htminuslab/Efinix_T20_Dev_Board/Examples/README.md

# 7 FPGA Examples

## 7.1 Hello World example

The "Hello World" design of an FPGA is normally a blinking LED, you can find such an example in the **examples\blink_led** directory. To upload this example issue the following command *(adjust -com xx for your com port)*:

```
EfinixLoader.exe -com 7 Example\blink_led\blink.hex
```
Note. The 3 LED's should now be blinking. 

<p align="center">
Blinking LED's
</p>

## 7.2 PLL Example

This is the same blinking LED example except a PLL is instantiated in the source, for this to work you need to enable the **Unified Netlist Flow** in the Efinity software (under edit project).

```
EfinixLoader.exe -com 7 Example\pll_test\pll_test.hex
```
Note. The 3 LED's should now again be blinking but this time driven by a 48MHz clock. 

## 7.3 UART bridge example

The on-board microcontroller provides an FPGA-UART to PC-UART (uart2uart) bridge. This makes it easy to connect your IP (with a UART) to the PC without requiring an external UART USB cable. 

<p align="center">
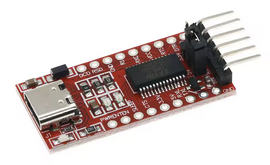
[picture p10: Examples/uart_ttl.png]
UART to TTL converter

</p>

You can find an example in the **examples\uart_echo** directory. This example echos back any characters it receives from the PC and adds one. Thus if you send a character '1' the program will echo back '2'. You will need terminal program like [putty](https://www.chiark.greenend.org.uk/~sgtatham/putty/latest.html) /teraterm to communicate with the board. The single tiny push button (GPIOB_TXP04,32) is connected to reset.

```
EfinixLoader.exe -com 7 Example\uart_echo\uart_echo.hex
```

The uart2uart bridge operates with a default bitrate of 115200bps, in this example the FPGA UART uses 9600,N,8,1 so we need to adjust the baudrate of the link. We can do this with the -fpgabaudrate argument:

```
h:\GitHub\Efinix_T20_Dev_Board\EfinixLoader>EfinixLoader.exe -com 7 -fpgabaudrate 9600
```
 
<p align="center">
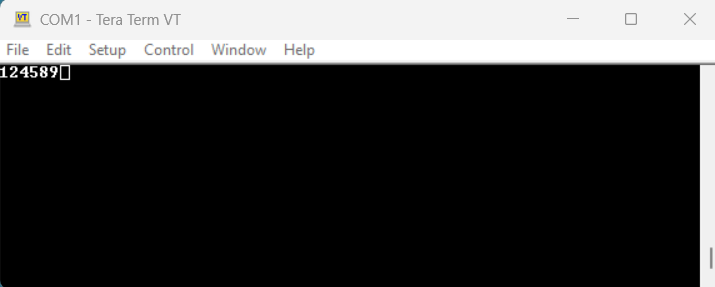
[picture p11: Examples/teraterm.png]
Teraterm connection

</p>
<p align="center">
Figure1: echo_uart example, sending '1' '4' '8'
</p>

## 7.4 Pin Toggle example

The on-board microcontroller has 17 pin connections with the Efinix FPGA. Some of these pins can be configured as input, output or special function such as UART TX/RX. The **examples\pin_level** directory contains a simple example that writes pin value (CMD input) as a string to the uart2uart bridge. The pin value and the reset are both controlled via the EfinixLoader program.

```
EfinixLoader.exe -com 7 Example\pin_level_pll\pin_level_pll.hex
```
Connect a terminal program to the second comport, use 115200,N,8,1 (any baudrate will work as we are talking to a USB UART not the FPGA UART). 

The STM32C071 pin PA15 is connected to the RESETN signal, and PC15 to the CMD input. Both pins default to input mode after power-up so to configure them as output we need to issue the following commands:

```
EfinixLoader.exe -com 7 -setdira 15 0
EfinixLoader.exe -com 7 -setdirc 15 0
```
These commands will change PA15/PC15 to 0=Output. You can now use the -setpin argument to change the pin value, for example to change the CMD pin (PC15) to 0 use:

```
EfinixLoader -com 7 -setpinc 15 0
```

To change it back to 1 use:

```
EfinixLoader -com 7 -setpinc 15 1
```

See batch file toggle_cmd.bat which toggles this pin a few times.  

Once you are done with the test it is recommended to change the port back to input(1):

```
EfinixLoader.exe -com 7 -setdira 15 1
EfinixLoader.exe -com 7 -setdirc 15 1
```

<p align="center">
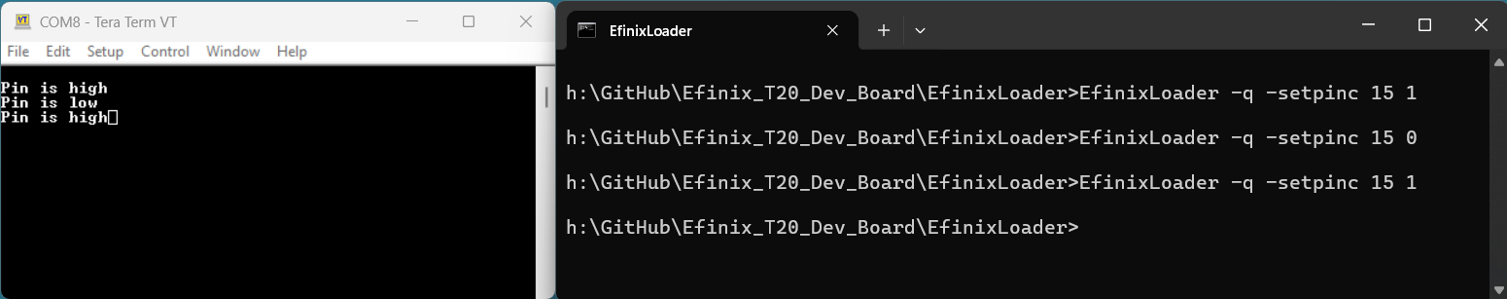
[picture p12: Examples/pin_level_pll.png]
pin_level_pll example

</p>
<p align="center">
Figure2:pin_level_pll example 
</p>

<span style="color:red">Please note there are no current limiting resistors between the STM32C071 and the T20Q100F3, so the user is responsible to not drive both the STM32C071 pin and the T20Q100F3 pin at the same time!</span>

<span style="color:red">In addition, this board does have an extra ESD protection on the I/O pins, so the usual common sense electronic component handling is required.</span> 

## 7.5 NEORV32 RISC-V Example

Every development boards needs a RISC-V core (ideally running Doom...:-), I picked the [NEORV32](https://github.com/stnolting/neorv32) which is a great core fully documented and available in VHDL/Verilog. I selected the "neorv32_ProcessorTop_MinimalBoot" configuration and added a PLL to increase the clock from 12 to 62.67MHz. I also recompiled the NEORV32 bootloader (neorv32-main/sw/bootloader) and some of the examples to use 115200bps instead of the default 19200. The amount of effort to get this core up and running was minimal which shows the quality of this core.

<p align="center">
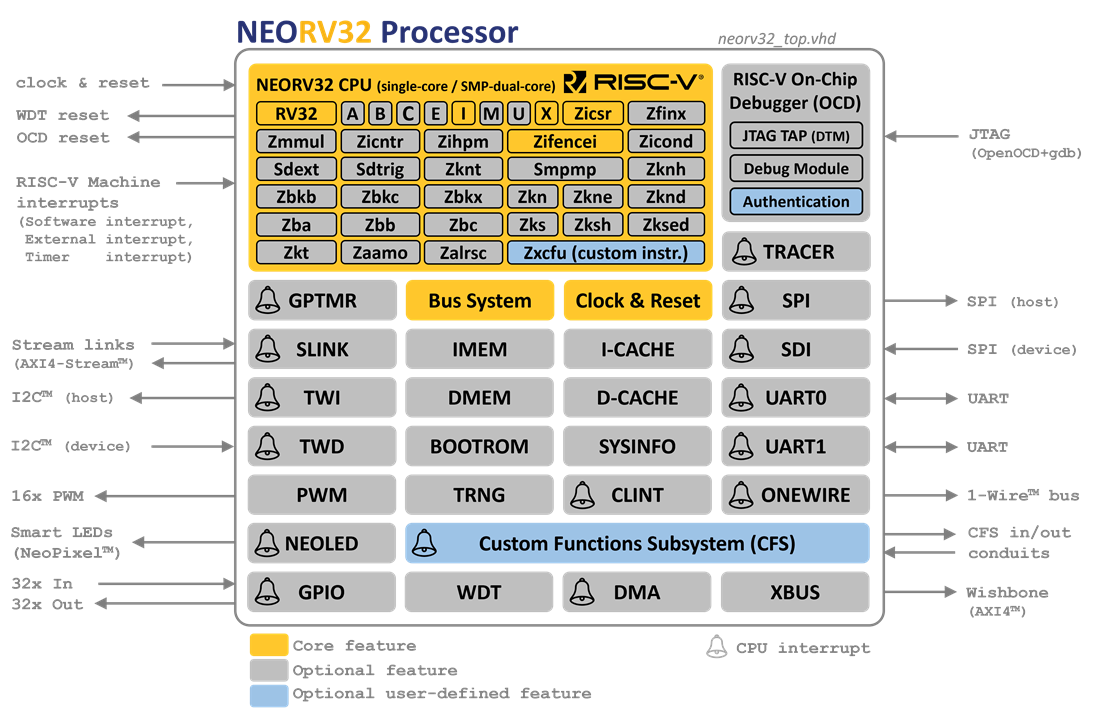
[picture p13: Examples/neorv32_processor.png]
NEORV32 RISC-V IP core

</p>
<p align="center">
Figure3: NEORV32 RISC-V IP core by Stephan Nolting
</p>

To load the design use:

```
EfinixLoader.exe -com 7 Example\neorv32_riscv\risc-v.hex
```

The RV32I core is configured with a single UART connected to the uart2uart bridge (115200,N,9,1). The reset pin is connected to PC15 and the PIO to the LEDs. After loading the design the terminal connected to the uart2uart bridge should show the bootloader menu, if not toggle the reset (see reset.bat file).

Once you have the bootloader you can upload a file and execute it. For this make sure you select binary option on your terminal (for example Tera Term) and disable the local echo. There are 2 example I pre-compiled, helloworld.bin and demo_blink_led.bin. Figure8 shows the helloworld.bin example output, after this excute reset.bat to get back to the bootloader menu.

<p align="center">
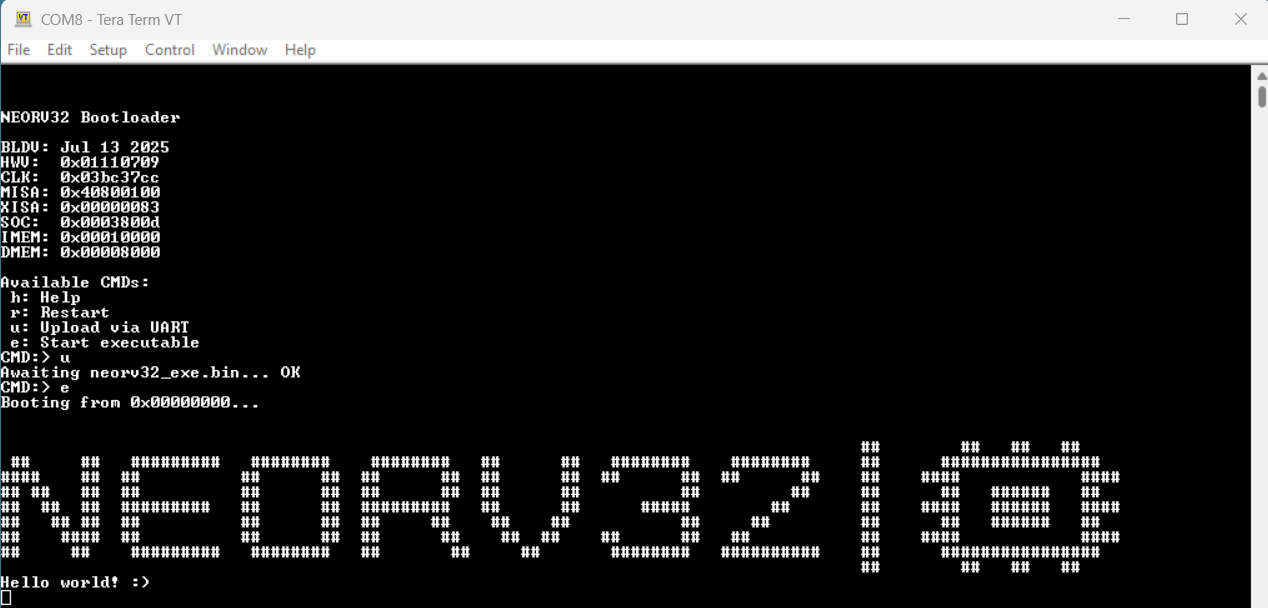
[picture p14: Examples/teraterm_riscv.png]
Teraterm running NEORV32 bootloader

</p>
<p align="center">
Figure4: Teraterm running NEORV32 bootloader
</p>

Here are the push-button synthesis results

```
---------- Resource Summary (begin) ----------
Inputs: 5 / 163 (3.07%)
Outputs: 6 / 347 (1.73%)
Clocks: 2 / 16 (12.50%)
Logic Elements: 5736 / 19728 (29.08%)
	LE: LUTs/Adders: 4378 / 19728 (22.19%)
	LE: Registers: 2379 / 13920 (17.09%)
Memory Blocks: 199 / 204 (97.55%)
Multipliers: 0 / 36 (0.00%)
---------- Resource Summary (end) ----------
---------- 1. Clock Frequency Summary (begin) ----------
User target constrained clocks
      Clock Name        Period (ns)  Frequency (MHz)   Waveform             Targets
EFX_PLL_V2_inst~CLKOUT0    15.957        62.668      {0.000 7.978} {EFX_PLL_V2_inst~CLKOUT0}

Maximum possible analyzed clocks frequency
      Clock Name        Period (ns)  Frequency (MHz)     Edge
EFX_PLL_V2_inst~CLKOUT0    13.089        76.400         (R-R)

Geomean max period: 13.089
---------- Clock Frequency Summary (end) ---------------
```

## 7.5.1 RISC-V RTL Simulation

I have also created a simple batch file for Questa/Modelsim to perform rtl and gatelevel simulation. Navigate to the sim directory and execute run_questa.bat in a CMD prompt, the output should be something like:

```
# set NumericStdNoWarnings 1
# 1
#  nolog -r /*
#  run 40 ms
# ** Note: [NEORV32] Implementing processor-internal IMEM as blank RAM.
#    Time: 0 ps  Iteration: 0  Instance: /neorv32_efinix_tb/U_DUT/neorv32_inst/memory_system/neorv32_int_imem_enabled/neorv32_int_imem_inst
# ** Warning: [NEORV32] Assuming this is a simulation.
#    Time: 0 ps  Iteration: 0  Region: /neorv32_efinix_tb/U_DUT/neorv32_inst/core_complex_gen(0)/neorv32_cpu_inst/hello_neorv32
# ** Note: [NEORV32] CPU tuning options:
#    Time: 0 ps  Iteration: 0  Region: /neorv32_efinix_tb/U_DUT/neorv32_inst/core_complex_gen(0)/neorv32_cpu_inst/hello_neorv32
# ** Note: [NEORV32] CPU ISA: rv32ix_zicntr_zicsr_zifencei
#    Time: 0 ps  Iteration: 0  Region: /neorv32_efinix_tb/U_DUT/neorv32_inst/core_complex_gen(0)/neorv32_cpu_inst/hello_neorv32
# ** Note: [NEORV32] BOOT_MODE_SELECT = 0: booting via bootloader
#    Time: 0 ps  Iteration: 0  Region: /neorv32_efinix_tb/U_DUT/neorv32_inst/sanity_checks
# ** Note: [NEORV32] Processor Configuration: CPU (single-core) IMEM DMEM BOOTROM CLINT GPIO UART0 SYSINFO
#    Time: 0 ps  Iteration: 0  Region: /neorv32_efinix_tb/U_DUT/neorv32_inst/sanity_checks
# ** Note: [NEORV32] The NEORV32 RISC-V Processor (v01.11.07.09), github.com/stnolting/neorv32
#    Time: 0 ps  Iteration: 0  Region: /neorv32_efinix_tb/U_DUT/neorv32_inst/sanity_checks
# N =  1, M =  94, O = 2, DIV0 =   9, DIV1 =   2, DIV2 =   2
# Using internal feedback
# CLKIN reference clock period = 83.3340 ns (12.00 MHz)
# VCO period = 0.8865 ns (1127.99 MHz)
# PLL period = 1.7731 ns (564.00 MHz)
# CLKOUT0 period = 15.9576 ns (62.67 MHz), shift = 0.0000 ns
# CLKOUT1 period = 3.5461 ns (282.00 MHz), shift = 0.0000 ns
# CLKOUT2 period = 3.5461 ns (282.00 MHz), shift = 0.0000 ns
# Reached Lock @ 1041.67 ns
# UART0:
# UART0: NEORV32 Bootloader
# UART0:
# UART0: BLDV: Jul 12 2025
# UART0: HWV:  0x01110709
# UART0: CLK:  0x03bc37cc
# UART0: MISA: 0x40800100
# UART0: XISA: 0x80000083
# UART0: SOC:  0x0003800d
# UART0: IMEM: 0x00008000
# UART0: DMEM: 0x00008000
# UART0:
# UART0: Available CMDs:
# UART0:  h: Help
# UART0:  r: Restart
# UART0:  u: Upload via UART
# UART0:  e: Start executable
```

## 7.5.2 RISC-V Gate Level Simulation

For gatelevel you first need to compiled the Efinix primitives into a library, you can do this with the following batch file (fix the <?> path):

```
vlib Efinix
vmap Efinix Efinix
vlog -quiet -work Efinix <?>/Efinity/2025.1/sim_models/verilog/*.v
vlog -quiet -work Efinix <?>/Efinity/2025.1/pt/sim_models/verilog/*.v

```
You will now have the gatelevel primitive and the simulation primitives (like EFX_PLL_V2) in the Efinix library. The gatelevel sim (structural only) can now be executed by the run_questa_gate.bat batch file:

```
# Loading std.standard
# Loading std.textio(body)
# Loading ieee.std_logic_1164(body)
# Loading ieee.numeric_std(body)
# Loading work.neorv32_efinix_tb(struct)#1
# Loading work.neorv32_efinix(fast)
# set NumericStdNoWarnings 1
# 1
#  nolog -r /*
#  run 40 ms
# N =  1, M =  94, O = 2, DIV0 =   9, DIV1 =   2, DIV2 =   2
# Using internal feedback
# CLKIN reference clock period = 83.3340 ns (12.00 MHz)
# VCO period = 0.8865 ns (1127.99 MHz)
# PLL period = 1.7731 ns (564.00 MHz)
# CLKOUT0 period = 15.9576 ns (62.67 MHz), shift = 0.0000 ns
# CLKOUT1 period = 3.5461 ns (282.00 MHz), shift = 0.0000 ns
# CLKOUT2 period = 3.5461 ns (282.00 MHz), shift = 0.0000 ns
# Reached Lock @ 1041.67 ns
# UART0:
# UART0: NEORV32 Bootloader
# UART0:
# UART0: BLDV: Jul 12 2025
# UART0: HWV:  0x01110709
# UART0: CLK:  0x03bc37cc
..etc
```

## 7.6 PLL Clock Output example

This example shows how to direct a PLL clock output to an I/O pin using the Unified Netlist mode. The PLL generates 48MHz from a 12MHz input clock signal.

```
EfinixLoader.exe -com 7 Example\pll_clkout\pll_clkout.hex
```

<p align="center">
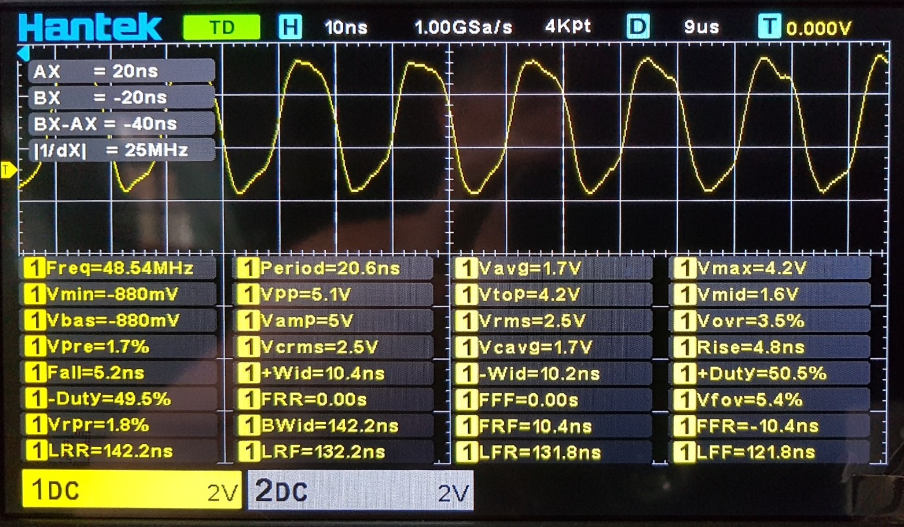
[picture p15: Examples/scope_clkout.jpg]
PLL Clock Out signal

</p>
<p align="center">
Figure5: PLL Clock output signal
</p>

## 7.7 Efinix Sapphire Lite core

Efinix has it own fully configurable RISC-V core based on the [award winning](https://riscv.org/blog/2018/12/risc-v-softcpu-contest-highlights/) [VexRISCV](https://github.com/SpinalHDL/VexRiscv) core. In addition to the core Efinix provide an easy to use Eclipse IDE. For this demo I selected the "lite" configuration with a single UART and the "uartEchodemo" example pre-loaded into memory (64KByte). To reduce the number of files I have stripped most of the IP files and just kept the files required to synthesise the core and to run RTL/Gatelevel sim. Re-generating the full core and restoring all the files is easy to do.

Here are some push-button synthesis results (all default values used in Efinity)

```
--------------- Resource Summary (begin) ---------------
Inputs:             4 / 163         (2.45%)
Outputs:            2 / 347         (0.58%)
Clocks:             1 / 16          (6.25%)
Logic Elements:     3046 / 19728    (15.44%)
   LE: LUTs/Adders: 2407 / 19728    (12.20%)
   LE: Registers:   1549 / 13920    (11.13%)
Memory Blocks:      134 / 204       (65.69%)
Multipliers:        0 / 36          (0.00%)
---------------- Resource Summary (end) ----------------

---------- 1. Clock Frequency Summary (begin) ----------
User target constrained clocks
      Clock Name        Period (ns)  Frequency (MHz)   Waveform             Targets
EFX_PLL_V2_inst~CLKOUT0    10.000        100.000     {0.000 5.000} {EFX_PLL_V2_inst~CLKOUT0}
Maximum possible analyzed clocks frequency
      Clock Name        Period (ns)  Frequency (MHz)     Edge
EFX_PLL_V2_inst~CLKOUT0    8.978        111.383         (R-R)
Geomean max period: 8.978
---------- Clock Frequency Summary (end) ---------------
```

**A RISC-V core with 64Kbyte of memory, 2Mbyte of Flash running at 111MHz(Timing_3) using just 16% of the available luts on a &pound;8 FPGA is quite good going (08/25).**

To load the design, start Teraterm(115200,N,8,1) or any other terminal program and execute:

```
EfinixLoader.exe -com 7 Examples\Efinix_riscv_lite\Efinix_riscv.hex
```

<p align="center">
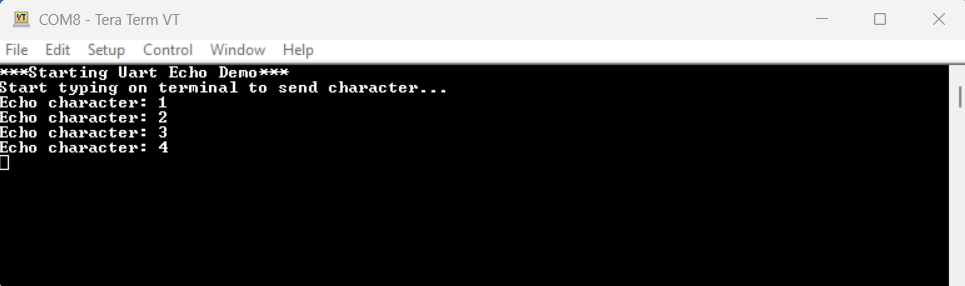
[picture p16: Examples/Efinix_riscv_echo.png]
Sapphire Uart Echo Demo

</p>
<p align="center">
Figure6: Sapphire Uart Echo Demo
</p>

The RESETN signal is connected to the microcontroller PA15 so to reset the core change the pin PA15 to output and then toggle it low and high.

```
EfinixLoader -q -com 7 -setdira 15 0
EfinixLoader -q -com 7 -setpina 15 0
EfinixLoader -q -com 7 -setpina 15 1
```

## 7.7.1 Efinix Sapphire Lite RTL Simulation

Similar to the neorv32 example to run RTL simulation navigate to the sim directory and execute the run_questa.bat file in a CMD prompt. You will first need to compile the Efinix primitives and sim_models into a "Efinix" library as shown under the neorv32 example.

```
# Loading work.t20_top_riscv_tb(rtl)#1
# Loading Efinix.EFX_PLL_V2(fast)
# Loading work.T20_Sapphire(fast)
# set NumericStdNoWarnings 1
# 1
#  nolog -r /*
#  run -all
# N =  1, M = 100, O = 2, DIV0 =   6, DIV1 =   2, DIV2 =   2
# Using internal feedback
# CLKIN reference clock period = 83.3340 ns (12.00 MHz)
# VCO period = 0.8333 ns (1199.99 MHz)
# PLL period = 1.6667 ns (600.00 MHz)
# CLKOUT0 period = 10.0001 ns (100.00 MHz), shift = 0.0000 ns
# CLKOUT1 period = 3.3334 ns (300.00 MHz), shift = 0.0000 ns
# CLKOUT2 period = 3.3334 ns (300.00 MHz), shift = 0.0000 ns
# Reached Lock @ 625.00 ns
# UART0: ***Starting Uart Echo Demo***
# UART0: Start typing on terminal to send character...
# Break key hit
# Simulation stop requested.
#  quit -f
```

## 7.7.2 Efinix Sapphire Lite GLS

For the gatelevel execute run_questa_gate.bat.

## 7.8 Flash/PSRAM Example

An easy way to access the embedded T20Q100F3 FLASH chip and external PSRAM chip is by using the Sapphire RISC-V core as it has all the peripherals you need (SPI/UART/PIO). For this example I picked the **standard** Sapphire core which, unlike the Lite version is optimised for performance. I configured the standard core with 4Kbyte I/D cache and added an extra SPI controller as shown below. 

<p align="center">
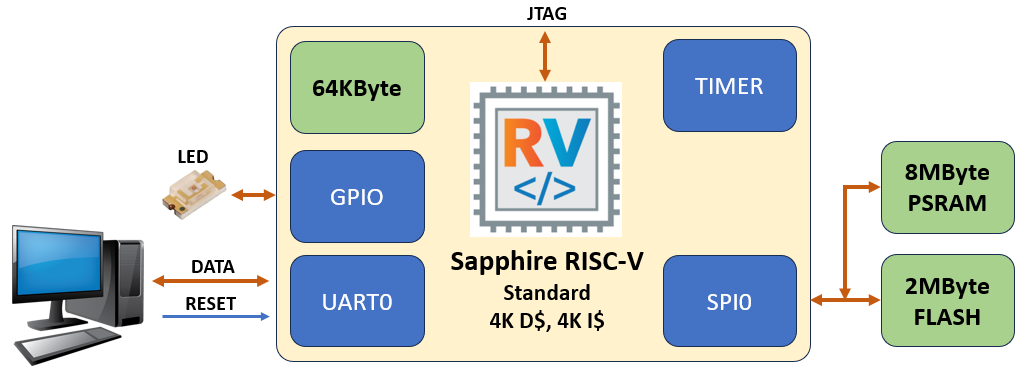
[picture p17: Examples/Efinix_riscv_standard.png]
Sapphire Flash Read test

</p>
<p align="center">
Figure7: Read flash with the Sapphire core
</p>

Next I wrote a quick program to read the first sector of both the FLASH and PSRAM and output the results to the UART, see *Examples\Efinix_riscv_standard\embedded_sw\T20_Sapphire\software\standalone\dumpFlash*. The RESETN signal is again connected to PA15. 

Before loading the Sapphire RISC core load the PSRAM and Flash with a recognisable pattern:

```
EfinixLoader.exe -com 7 -psram Examples\Efinix_riscv_standard\pattern1.hex
EfinixLoader.exe -com 7 -flash Examples\Efinix_riscv_standard\pattern2.hex
```

Next load the Sapphire Standard core which will display the first sector of both the Flash and PSRAM straight after reset:

```
EfinixLoader.exe -com 7 Examples\Efinix_riscv_standard\Efinix_riscv_standard.hex
```

Open a terminal and connect Teraterm(115200,n,8,1) to the UART2UART bridge comport. Once the program is loaded it should display the flash and PSRAM contents:

```
*** Device ID : 00000014

*** Dump First Page of FLASH:

00000000: 56 65 72 73 69 6F 6E 3A 20 32 30 32 35 2E 31 2E
00000010: 31 31 30 2E 31 2E 35 0A 47 65 6E 65 72 61 74 65
00000020: 64 3A 20 53 61 74 20 4A 75 6E 20 32 38 20 30 39
00000030: 3A 31 38 3A 35 31 20 32 30 32 35 0A 0A 50 72 6F
00000040: 6A 65 63 74 3A 20 48 3A 5C 47 69 74 48 75 62 5C
00000050: 45 66 69 6E 69 78 5F 54 32 30 5F 44 65 76 5F 42
00000060: 6F 61 72 64 5C 45 78 61 6D 70 6C 65 73 5C 62 6C
00000070: 69 6E 6B 5F 6C 65 64 0A 46 61 6D 69 6C 79 3A 20
00000080: 54 72 69 6F 6E 0A 44 65 76 69 63 65 3A 20 54 32
00000090: 30 51 31 30 30 46 33 0A 57 69 64 74 68 3A 20 31
000000a0: 0A 4D 6F 64 65 3A 20 70 61 73 73 69 76 65 0A 50
000000b0: 41 44 44 45 44 5F 42 49 54 53 3A 20 30 0A 0A 0A
000000c0: 0A 0A 0A 0A 0A 0A 0A 0A 0A 0A 0A 0A 0A 0A 0A 0A
000000d0: 0A 0A 0A 0A 0A 0A 0A 0A 0A 0A 0A 0A 0A 0A 0A 0A
000000e0: 0A 0A 0A 0A 0A 0A 0A 0A 0A 0A 0A 0A 0A 0A 0A 0A
000000f0: 0A 0A 0A 0A 0A 0A 0A 0A 0A 0A 0A 0A 0A 0A 0A 0A

*** Dump First Page of PSRAM:

00000000: 01 02 03 04 05 06 07 08 09 0A 0B 0C 0D 0E 0F 20
00000010: 21 22 23 24 25 26 27 28 29 2A 2B 2C 2D 2E 2F 30
00000020: 0A 0A 0A 0A 0A 0A 0A 0A 0A 0A 0A 0A 0A 0A 0A 0A
00000030: 0A 0A 0A 0A 0A 0A 0A 0A 0A 0A 0A 0A 0A 0A 0A 0A
00000040: 0A 0A 0A 0A 0A 0A 0A 0A 0A 0A 0A 0A 0A 0A 0A 0A
00000050: 0A 0A 0A 0A 0A 0A 0A 0A 0A 0A 0A 0A 0A 0A 0A 0A
00000060: 0A 0A 0A 0A 0A 0A 0A 0A 0A 0A 0A 0A 0A 0A 0A 0A
00000070: 0A 0A 0A 0A 0A 0A 0A 0A 0A 0A 0A 0A 0A 0A 0A 0A
00000080: 0A 0A 0A 0A 0A 0A 0A 0A 0A 0A 0A 0A 0A 0A 0A 0A
00000090: 0A 0A 0A 0A 0A 0A 0A 0A 0A 0A 0A 0A 0A 0A 0A 0A
000000a0: 0A 0A 0A 0A 0A 0A 0A 0A 0A 0A 0A 0A 0A 0A 0A 0A
000000b0: 0A 0A 0A 0A 0A 0A 0A 0A 0A 0A 0A 0A 0A 0A 0A 0A
000000c0: 0A 0A 0A 0A 0A 0A 0A 0A 0A 0A 0A 0A 0A 0A 0A 0A
000000d0: 0A 0A 0A 0A 0A 0A 0A 0A 0A 0A 0A 0A 0A 0A 0A 0A
000000e0: 0A 0A 0A 0A 0A 0A 0A 0A 0A 0A 0A 0A 0A 0A 0A 0A
000000f0: 0A 0A 0A 0A 0A 0A 0A 0A 0A 0A 0A 0A 0A 0A 0A 0A

Done

```
The Flash output should be the same as pattern1.hex, the PSRAM should display pattern2.hex.

If you get all **"FF"** for the Flash page, issue a reset as the flash might take some time to get out of deep sleep mode. 

```
H:\GitHub\Efinix_T20_Dev_Board\EfinixLoader>..\Examples\Efinix_riscv_lite\toggle_reset.bat
```

## 7.8.1 Efinix Sapphire Standard RTL Simulation

Similar to the previous RISC-v examples to run RTL simulation navigate to the sim directory and execute the run_questa.bat file in a CMD prompt. The flash model (W25Q32JVxxIM.v) is initialised with the content of MEM_IM.txt the PSRAM is not connected and will display all ".".  

```
# Loading work.T20_Sapphire(fast)
# Loading Efinix.EFX_PLL_V2(fast)
# Loading work.W25Q32JVxxIM(fast)
# set NumericStdNoWarnings 1
# 1
#  nolog -r /*
#  run -all
# N =  1, M = 100, O = 2, DIV0 =   6, DIV1 =   2, DIV2 =   2
# Using internal feedback
# CLKIN reference clock period = 83.3340 ns (12.00 MHz)
# VCO period = 0.8333 ns (1199.99 MHz)
# PLL period = 1.6667 ns (600.00 MHz)
# CLKOUT0 period = 10.0001 ns (100.00 MHz), shift = 0.0000 ns
# CLKOUT1 period = 3.3334 ns (300.00 MHz), shift = 0.0000 ns
# CLKOUT2 period = 3.3334 ns (300.00 MHz), shift = 0.0000 ns
# Reached Lock @ 625.00 ns
#
# Command = ab
#
# Command = 03
# UART0:
# UART0: *** Device ID : 00000015
# UART0:
# UART0: *** Dump First Page of Flash:
# UART0:
# UART0: 00000000: 56 65 72 73 69 6F 6E 3A 20 32 30 32 35 2E 31 2E
# UART0: 00000010: 31 31 30 2E 31 2E 35 0A 47 65 6E 65 72 61 74 65
# UART0: 00000020: 64 3A 20 57 65 64 20 4A 75 6C 20 33 30 20 30 38
# UART0: 00000030: 3A 33 37 3A 30 32 20 32 30 32 35 0A 0A 50 72 6F
# UART0: 00000040: 6A 65 63 74 3A 20 48 3A 5C 47 69 74 48 75 62 5C
...
```

## 7.8.2 Efinix Sapphire Standard GLS

[TBC]

## 7.9 Create your own design

To create your own design you need the [Efinix Efinity Place&Route](https://www.efinixinc.com/products-efinity.html) software. You need to sign-up to get a free license. I would also suggest you check out the [forum](https://forum.efinix.net/latest) which has some good advice on various issues.

## License

- All example code is licensed under the [MIT License](../MIT_License.txt).

## Notice
All other trademarks are the property of their respective owners.
