htminuslab/Efinix_T20_Dev_Board/Examples/teraterm_readpsram.png

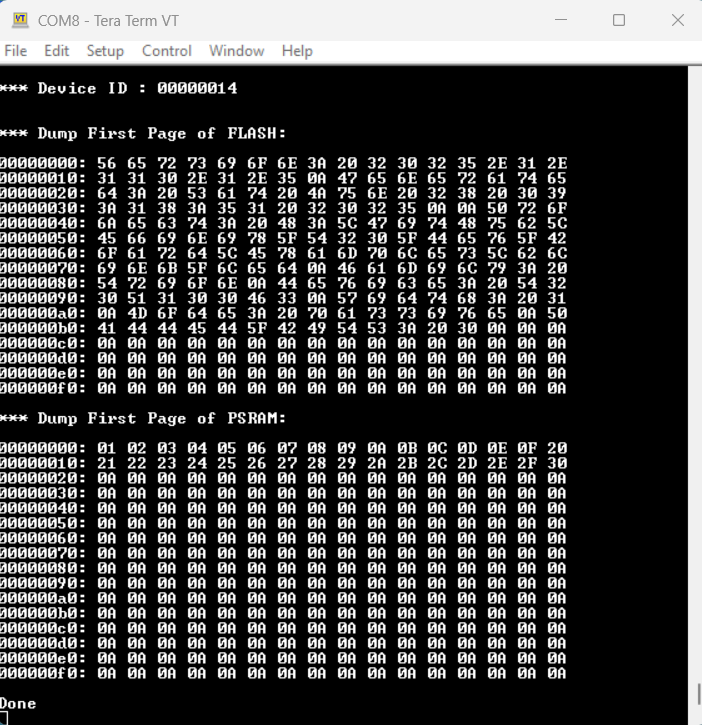
Examples/teraterm_readpsram.png
