htminuslab/Efinix_T20_Dev_Board/PCB/pcbway_parts_list.xls

PCBWay Bom Quotation, Product No.:T-3C2W801330A
Item # | *Designator | *Qty | Manufacturer | *Mfg Part # | Description / Value | Vendor Part # | *Package/Footprint | Mounting Type | Your Instructions / Notes | *Unit Price(1 set) | *Total | *Delivery Time | *PCBWay Note | Customer Reply | PCBWay Update
1 | C1,C9,C11,C13,C17,C19,C21,C23,C25,C27,C29,C31,C33,C35,C37,C39,C45,C47,C49,C52,C56 | 21 | Walsin(华新科) | 0603B103K500CT | 10n | LCSC Electronics『 』C302009 | Capacitor_SMD:C_0603_1608Metric | SMD | Any manufacturer will do | $0.013 | $0.273
2 | C2,C3,C4,C6,C8,C10,C12,C15,C16,C18,C20,C22,C24,C26,C28,C30,C32,C34,C36,C38,C44,C46,C48,C55,C58,C90 | 26 | CCTC(三环) | TCC0603X7R104K500CT | 100n | LCSC Electronics『 』C282519 | Capacitor_SMD:C_0603_1608Metric | SMD | Any manufacturer will do | $0.010 | $0.260
3 | C5,C7,C54 | 3 | SAMSUNG(三星) | CL10A105KO8NNNC | 1u | LCSC Electronics『 』C1592 | Capacitor_SMD:C_0603_1608Metric | SMD | Any manufacturer will do | $0.017 | $0.051
4 | C88,C89 | 2 | Chinocera(华瓷) | HGC0805R5476M100NSLJ | 47u | LCSC Electronics『 』C19103846 | Capacitor_SMD:C_0805_2012Metric | SMD | Any manufacturer will do | $0.260 | $0.520
5 | R8 | 1 | FOJAN(富捷) | FRC0603F33R0TS | 33R | LCSC Electronics『 』C2909394 | Resistor_SMD:R_0603_1608Metric | SMD | Any manufacturer will do | $0.061 | $0.061
6 | R6,R7,R16,R18,R19,R20,R21,R22,R23 | 9 | YAGEO(国巨) | RT0603BRD0710KL | 10K | LCSC Electronics『 』C95204 | Resistor_SMD:R_0603_1608Metric | SMD | Any manufacturer will do | $0.062 | $0.558
7 | R9,R10 | 2 | UNI-ROYAL(厚声) | 0603WAF1003T5E | 100K | LCSC Electronics『 』C25803 | Resistor_SMD:R_0603_1608Metric | SMD | Any manufacturer will do | $0.027 | $0.054
8 | R1,R4,R5,R11,R17,R24 | 6 | YAGEO(国巨) | RT0603BRD071K5L | 1K5 | LCSC Electronics『 』C705741 | Resistor_SMD:R_0603_1608Metric | SMD | Any manufacturer will do | $0.109 | $0.654
9 | C14,C51,C53,C57 | 4 | YAGEO(国巨) | CC0805KKX7R9BB225 | 2u2 | LCSC Electronics『 』C125847 | Capacitor_SMD:C_0805_2012Metric | SMD | Any manufacturer will do | $0.197 | $0.788
10 | FB1 | 1 | FH(风华) | CBM160808U330T | 33R@100MHz | LCSC Electronics『 』C394422 | Inductor_SMD:L_0603_1608Metric | SMD | Any manufacturer will do | $0.507 | $0.507
11 | R2,R3,R12,R13,R14,R15 | 6 | YAGEO(国巨) | RT0603BRD075K1L | 5K1 | LCSC Electronics『 』C122969 | Resistor_SMD:R_0603_1608Metric | SMD | Any manufacturer will do | $0.097 | $0.582
12 | FB2 | 1 | chilisin(奇力新) | SBK160808T-601Y-N | 600R@100MHz | LCSC Electronics『 』C280690 | Inductor_SMD:L_0603_1608Metric | SMD | Any manufacturer will do | $0.111 | $0.111
13 | D1 | 1 | yongyu(永裕光电) | SZYY1206B | LED | LCSC Electronics『 』C434440 | LED_SMD:LED_1206_3216Metric | SMD | Blue LED, Any manufacturer will do | $1.140 | $1.140
14 | D6 | 1 | yongyu(永裕光电) | SZYY1206W | LED | LCSC Electronics『 』C434441 | LED_SMD:LED_1206_3216Metric | SMD | Yellow LED, Any manufacturer will do | $1.182 | $1.182
15 | D3 | 1 | HONGLITRONIC(Hongli Zhihui (HONGLITRONIC)) | HL-PC-3216S52FC-L | LED | LCSC Electronics『 』C499461 | LED_SMD:LED_1206_3216Metric | SMD | Red LED, Any manufacturer will do | $0.614 | $0.614
16 | D4 | 1 | HONGLITRONIC(Hongli Zhihui (HONGLITRONIC)) | HL-PC-3216H392BC-L | LED | LCSC Electronics『 』C499462 | LED_SMD:LED_1206_3216Metric | SMD | Blue LED, Any manufacturer will do | $1.051 | $1.051
17 | D5 | 1 | HONGLITRONIC(Hongli Zhihui (HONGLITRONIC)) | HL-PC-3216S52FC-L | LED | LCSC Electronics『 』C499461 | LED_SMD:LED_1206_3216Metric | SMD | Red LED,Any manufacturer will do | $0.614 | $0.614
18 | U4 | 1 | TI(德州仪器) | LM3880MF-1AA/NOPB | LM3880 | LCSC Electronics『 』C486059 | Package_TO_SOT_SMD:SOT-23-6 | SMD |  | $0.833 | $0.833
19 | D2 | 1 | MSKSEMI(美森科) | SP0503BAHTG-MS | SP0503BAHT | LCSC Electronics『 』C3029025 | Package_TO_SOT_SMD:SOT-143 | SMD |  | $0.416 | $0.416
20 | U1 | 1 | ST(意法半导体) | STM32C071GBU6N | STM32C071GBUxN | LCSC Electronics『 』C42240018 | Package_DFN_QFN:QFN-28_4x4mm_P0.5mm | SMD |  | $1.659 | $1.659
21 | SW2 | 1 | C&K | KMR221NGLFS | SW_Push | LCSC Electronics『 』C269272 | Button_Switch_SMD:SW_Push_1P1T_NO_CK_KMR2 | SMD |  | $0.704 | $0.704
22 | U3 | 1 | Efinix | T20Q100F3C4 | T20Q100F3C4 | Efinix『 』T20Q100F3C4 | Efinix:LQFP100_TRION_EFI | SMD | Digikey part number 2134-T20Q100F3C4-ND | $15.990 | $15.990
23 | U5 | 1 | TI(德州仪器) | TLV75533PDBVR | TLV75533PDBV | LCSC Electronics『 』C404027 | Package_TO_SOT_SMD:SOT-23-5 | SMD |  | $0.403 | $0.403
24 | U6 | 1 | TI(德州仪器) | TLV70212DBVR | TLV70212_SOT23-5 | LCSC Electronics『 』C81462 | Package_TO_SOT_SMD:SOT-23-5 | SMD |  | $0.814 | $0.814
25 | J6 | 1 | G-Switch(品赞) | GT-USB-7010ASV | USB_C_Receptacle_USB2.0_14P | LCSC Electronics『 』C2988369 | USB_C_Receptacle_G-Switch_GT-USB-7010ASV_mod | SMD |  | $0.526 | $0.526
