htminuslab/Efinix_T20_Dev_Board/PCB/Schematics_DevBoard_H2.pdf

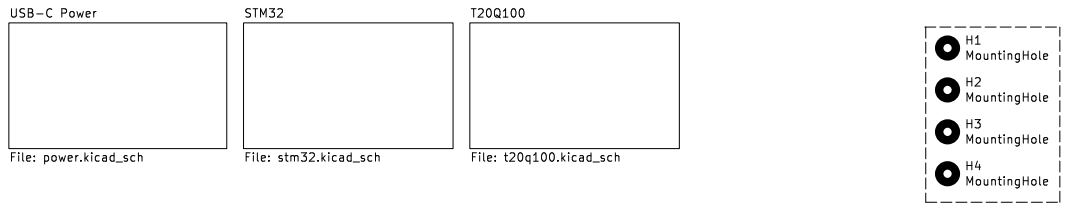
[picture p22: page 1]

File: T20Q100_DevBoard_H2.kicad_sch Sheet: / HT-LAB

Id: 1/4 Title: Efinix T20Q100 Development Board

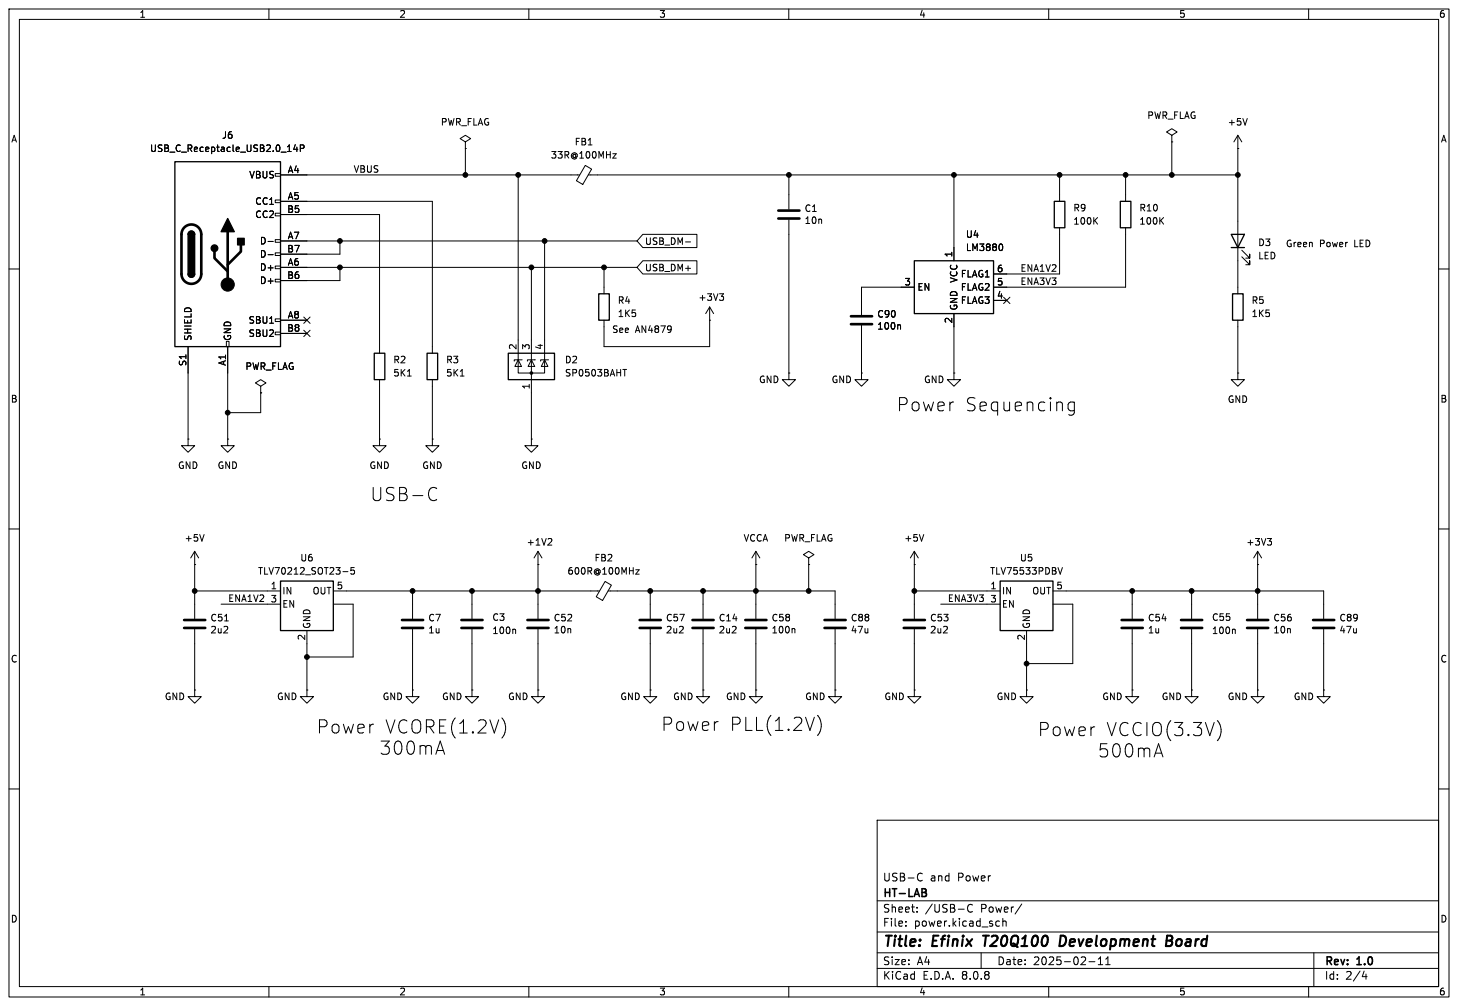
[picture p23: page 2]

2 EN 3 OUT 5 U6 TLV70212_SOT23-5 GND GND

2 EN 3 OUT 5 U5 TLV75533PDBV GND GND

Id: 2/4 Title: Efinix T20Q100 Development Board

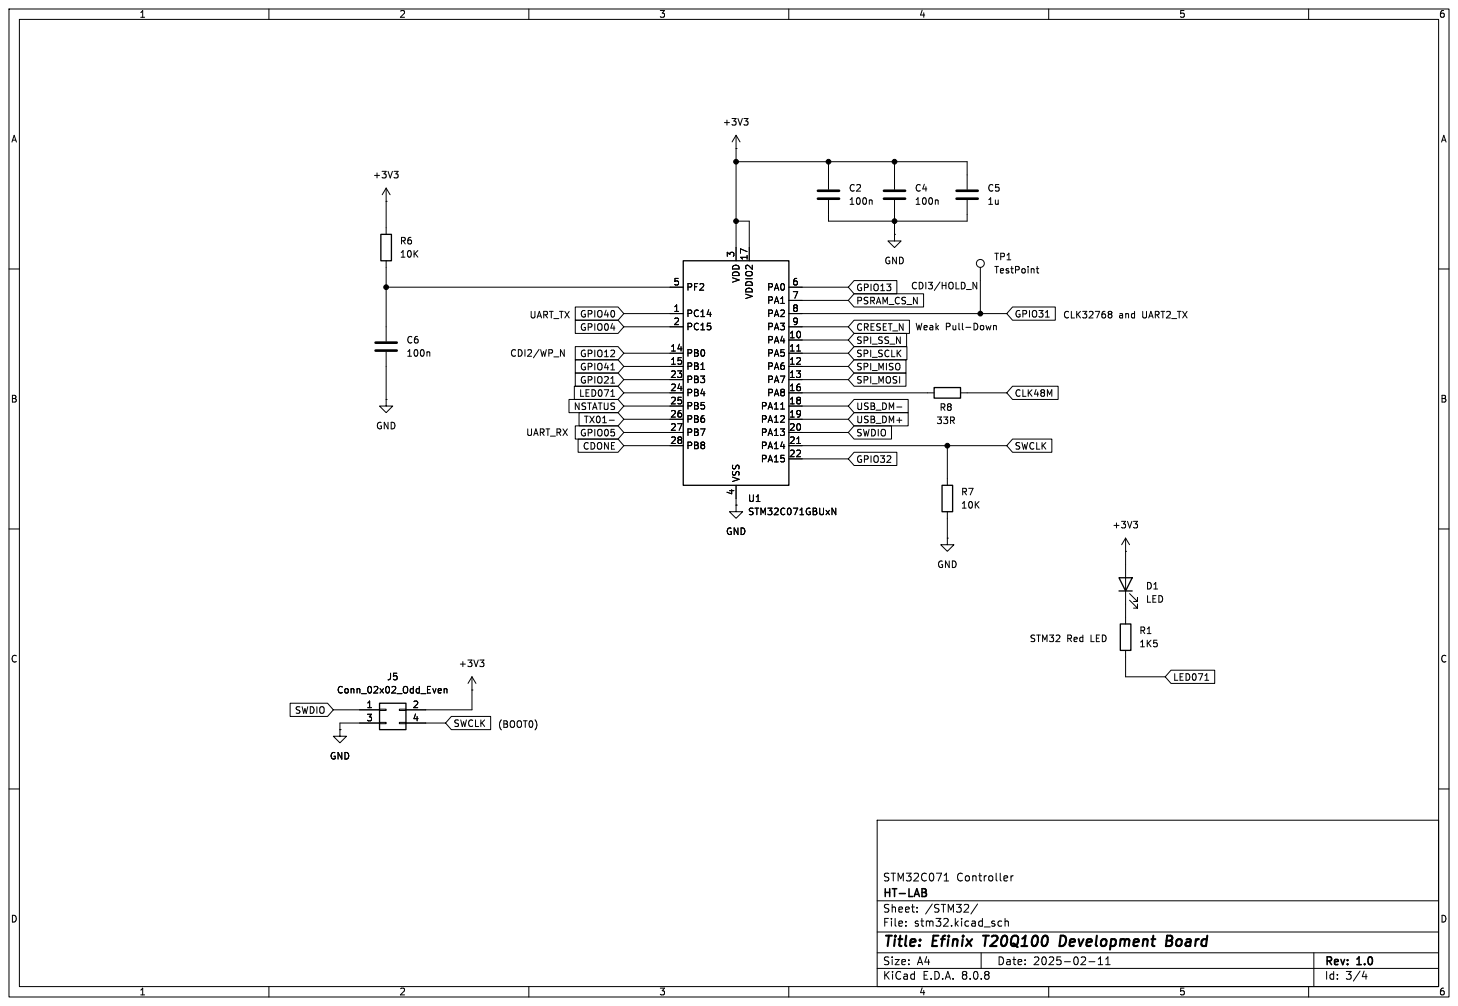
[picture p24: page 3]

File: stm32.kicad_sch Sheet: /STM32/ HT-LAB

Id: 3/4 Title: Efinix T20Q100 Development Board

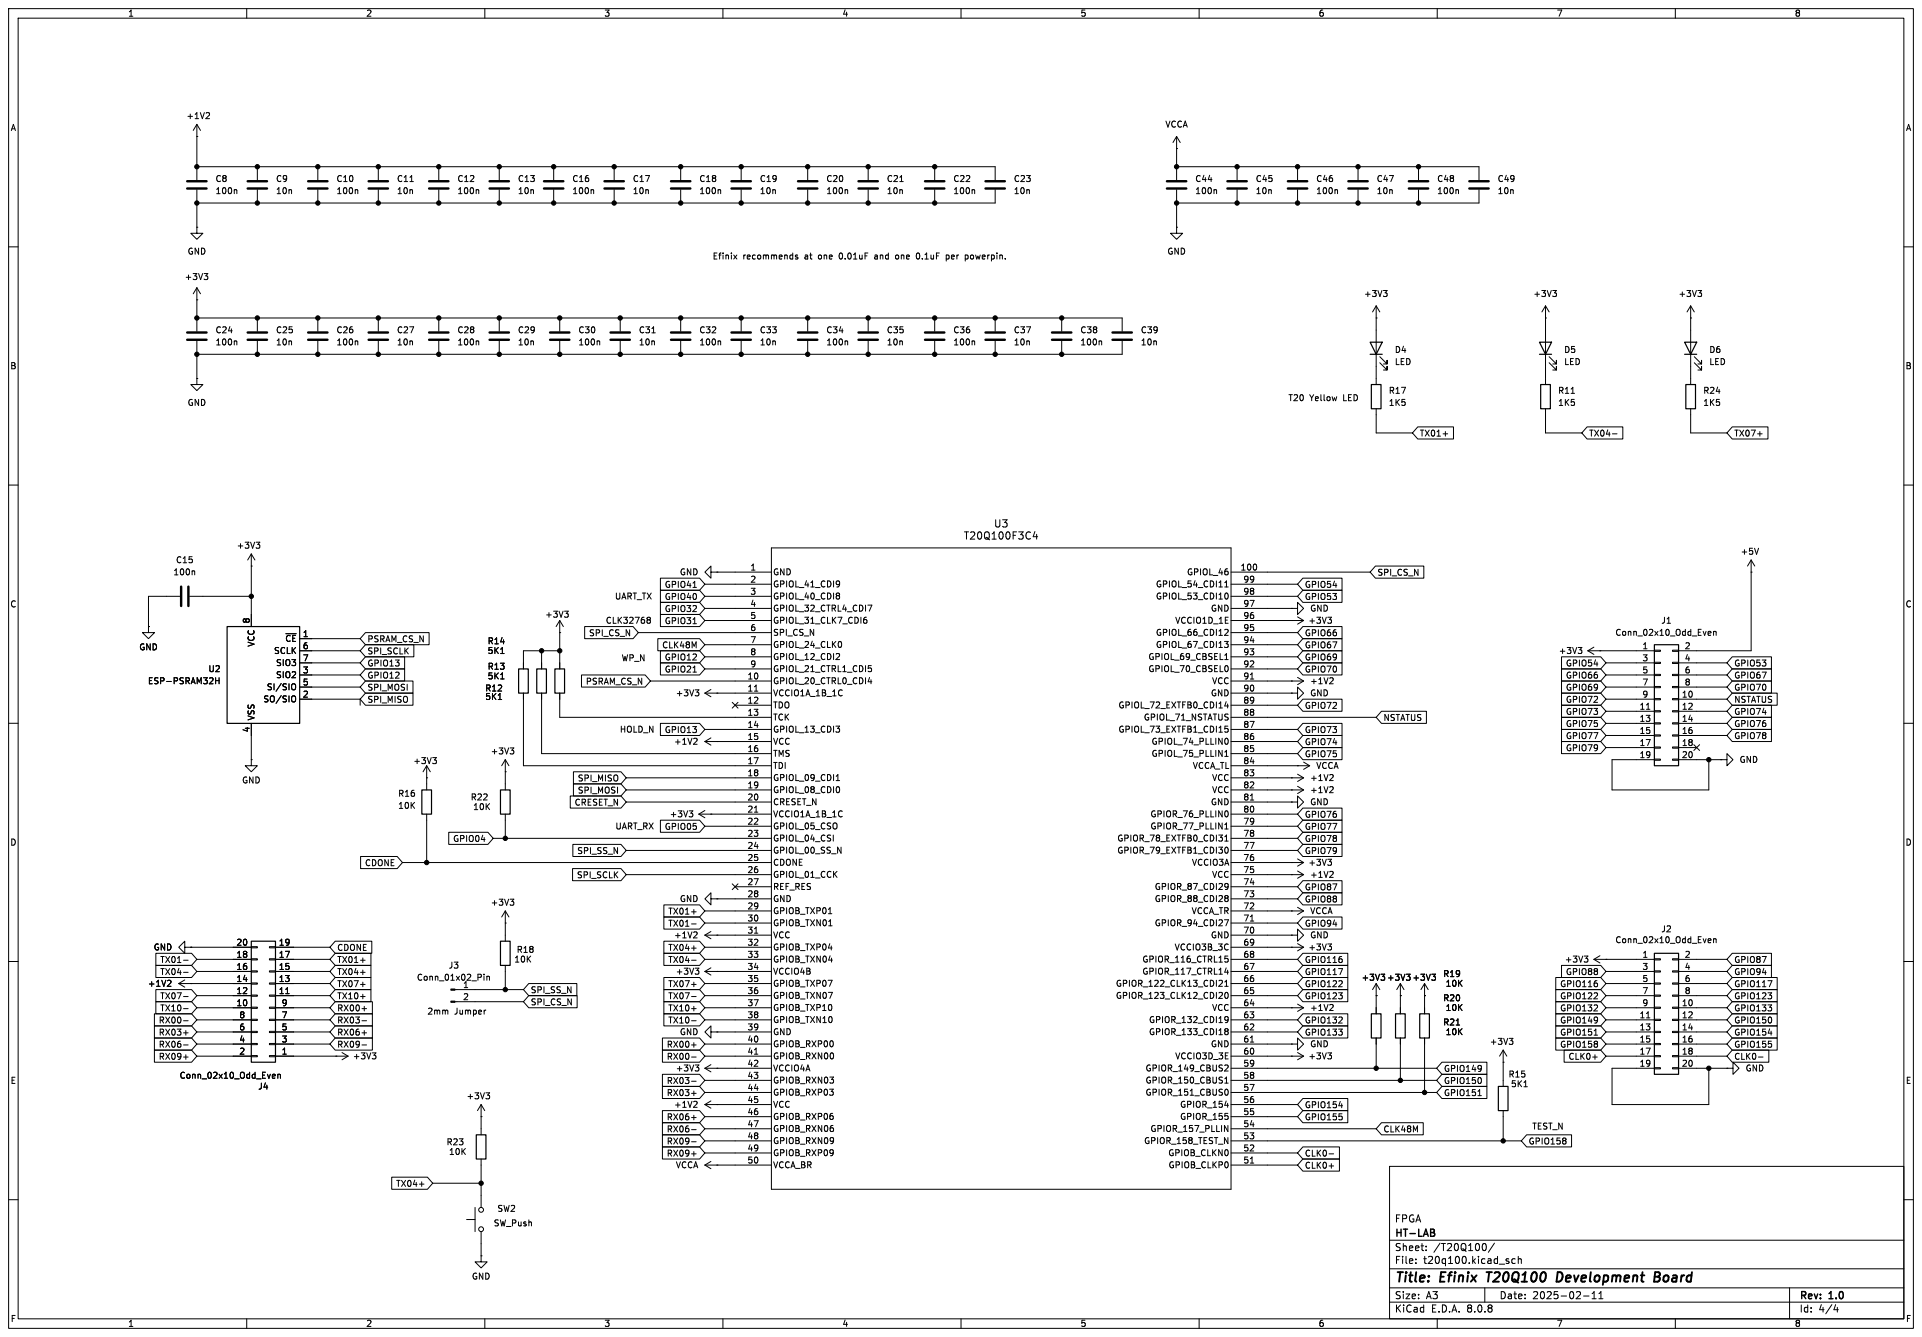
[picture p25: page 4]

4 SI/SIO 5 SCLK 6 SIO3 7 VCC
~{CE}1 SO/SIO 2 SIO2 3 VSS

FPGA
File: t20q100.kicad_sch Sheet: /T20Q100/ HT-LAB

Id: 4/4 Title: Efinix T20Q100 Development Board
