htminuslab/Efinix_T20_Dev_Board/PCB/silkscreen.pdf

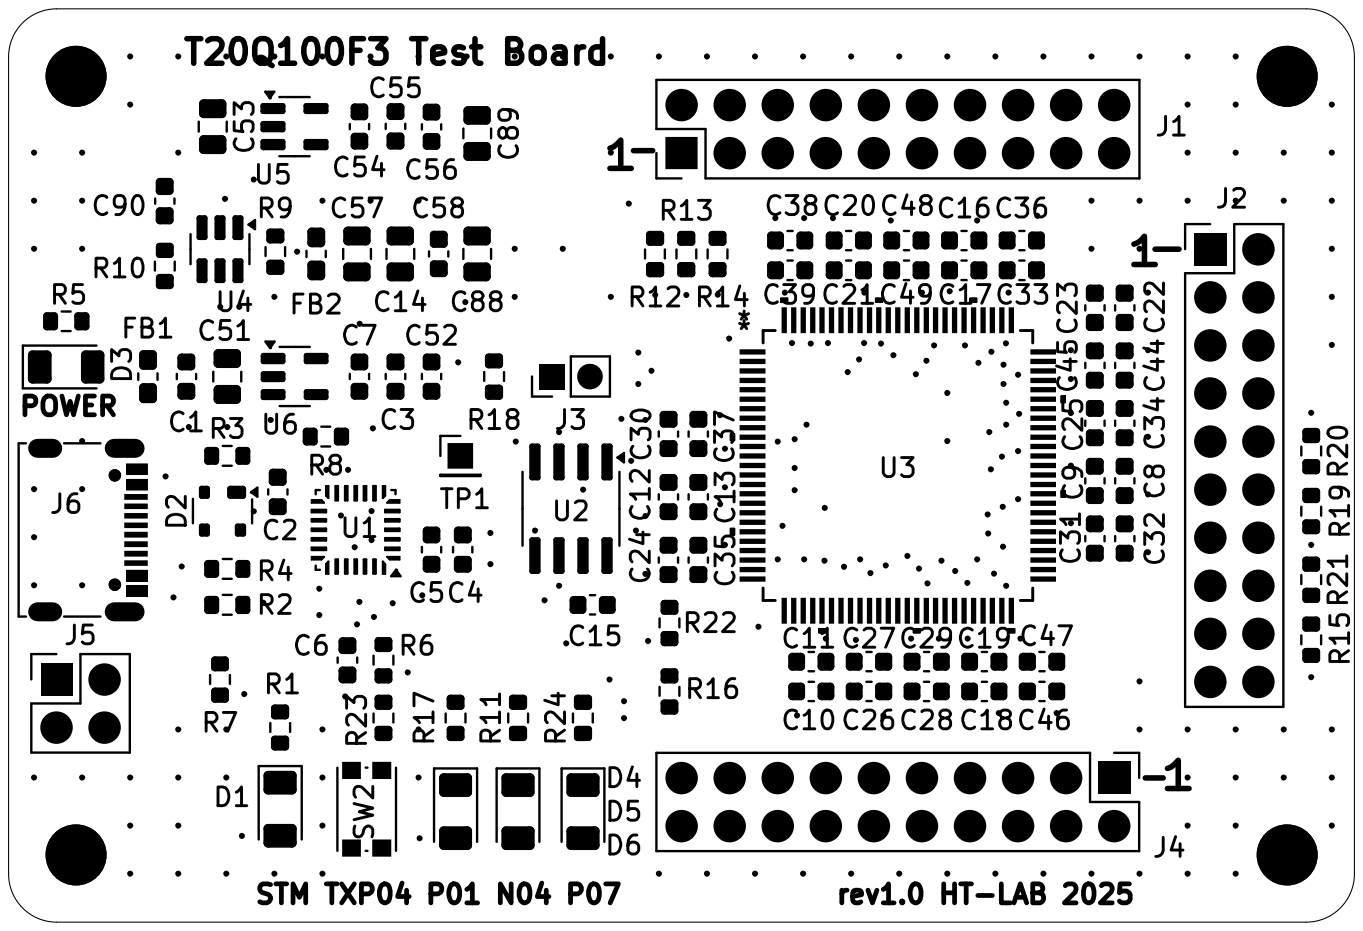
[picture p26: page 1]
