htminuslab/Efinix_T20_Dev_Board/Examples/Efinix_riscv_standard/T20_Top_RISCV_prot.vhd

---------------------------------------------------------------------------------------------------
--                                                                           
--  T20Q100 Sapphire port
--                                         
--  Copyright (C) 2025 HT-LAB                                           
--                                                                                                            
--  https://github.com/htminuslab    
--                                                                          
---------------------------------------------------------------------------------------------------        
--
--	Standard Sapphire core + SPI + UART + Timer		 
--
--  Revision History:                                                        
--                                                                           
--  Date:          Revision         Author         
--  14-jun-2025	   1.0				HABT
---------------------------------------------------------------------------------------------------

library ieee;
use ieee.std_logic_1164.all;
USE ieee.numeric_std.all;

entity T20_TOP_RISCV is
   port( 
		CLK     	: in  std_logic;
		RESETN  	: in  std_logic;
		
		CCK			: out std_logic;					-- Flash SPI interface
		MISO        : inout std_logic;
		MOSI		: inout std_logic;
		WPN_N		: inout std_logic;					-- IO2 in QSPI
		HOLD_N		: inout std_logic;					-- IO3 in QSPI
		SPI_CS_N	: out std_logic;					-- Flash SS
		
		RX      	: in  std_logic;
		TX      	: out std_logic);
end T20_TOP_RISCV;


`protect begin_protected
`protect version = 1
`protect author = "author-a" , author_info = "author-a-details"
`protect encrypt_agent = "QuestaSim" , encrypt_agent_info = "2025.1"
`protect key_keyowner = "Efinix Inc." , key_keyname = "EFX_K01"
`protect key_method = "rsa"
`protect encoding = ( enctype = "base64" , line_length = 64 , bytes = 256 )
`protect key_block
MzQoSF1nvg7AoBdM/75mUW+4AI/21mBJH2CQYNnHNAPTnrp1SfXwtwGMmoLRm/IH
QN8PjmzEO0Qacj30FNw7WYvdHGa1X4yGjYVRX6Xwf4QC8DoiZoPpGIMAkbfr5pg0
NS6PF8/Ti0RExtVeY1ScG8mC5tvarnk1x4WHHVpHJsXqFAZg9ApSc7X6es8w4ZhJ
O1mB3kpK8EA7u0YqZYartCOFbVuTXhuO8Rwx03x+TQk17Yd9ew+4ZxZ1npuFqJaJ
+b31wUpIwEgk40ByvvHgcgFkAsu/mSBCuaptLdwmz5Ptuqx+Do1OB1FO+hJdle+j
9tvAaHOfRd1eXS0E973h/Q==
`protect key_keyowner = "Siemens" , key_keyname = "SIEMENS-VERIF-SIM-RSA-2"
`protect key_method = "rsa"
`protect encoding = ( enctype = "base64" , line_length = 64 , bytes = 256 )
`protect key_block
apR+uQD8AjlweCjFr0H6+4A+IbHIjYg09xF6fVBm7eDTJ4PHy/dUapS62P4G9JtL
WDTDM9XtZECO/TZo9ZZPfo0sZYi+eYDfcBOH3/bU56grZi6EZMVaLAwyDQrE7hGt
H/RuA7LlQGyRsTp5YDG0iJTxL/A4xQhV/tF7fo56We/KnAtlaEjbBy7wuPnfspdx
1ZEe5B5QCCaLRxzfPausfGdQxO2K/MDJotCl64g5931c33sjPAfgPB5iu2YH685G
yUZrwk+97vLl7xrHoMrFlMFqQ38jUUUY/w6ieII5TcptCKGF2n3Z7/Fvph2sm3Pd
bZBKgFl3XqWWKb5M10uxrg==
`protect data_method = "aes256-cbc"
`protect encoding = ( enctype = "base64" , line_length = 64 , bytes = 6384 )
`protect data_block
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
`protect end_protected	
