htminuslab/Efinix_T20_Dev_Board/Examples/Efinix_riscv_standard/T20_Top_RISCV.v

module T20_TOP_RISCV_VER (
    input  wire CLK,
    input  wire RESETN,
    output wire CCK,
    inout  wire MISO,
    inout  wire MOSI,
    inout  wire WPN_N,
    inout  wire HOLD_N,
    output wire SPI_CS_N,
    input  wire RX,
    output wire TX
);

`pragma protect version=1
`pragma protect author="author-a", author_info="author-a-details"
`pragma protect data_method="aes256-cbc"

`protect key_keyowner="Siemens"
`protect key_keyname="SIEMENS-VERIF-SIM-RSA-1"
`protect key_method="rsa"
`protect rights_digest_method = "sha256"
`protect key_public_key
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
vwIDAQAB


`pragma protect key_keyowner="Efinix Inc."
`pragma protect key_keyname="EFX_K01"
`pragma protect key_method="rsa"
`pragma protect key_public_key
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
3wIDAQAB

`pragma protect begin


    T20_TOP_RISCV inst (			// Instantiate VHDL top level
        .CLK(CLK),
        .RESETN(RESETN),
        .CCK(CCK),
        .MISO(MISO),
        .MOSI(MOSI),
        .WPN_N(WPN_N),
        .HOLD_N(HOLD_N),
        .SPI_CS_N(SPI_CS_N),
        .RX(RX),
        .TX(TX)
    );

endmodule

`pragma protect end
