htminuslab/Efinix_T20_Dev_Board/Examples/Efinix_riscv_standard/embedded_sw/T20_Sapphire/bsp/efinix/EfxSapphireSoc/include/soc.h

#ifndef SOC_H
#define SOC_H
#define SYSTEM_DEBUG_MODULE_SOFT_TAP 1
#define SYSTEM_PLIC_SYSTEM_CORES_0_EXTERNAL_INTERRUPT 0
#define SYSTEM_PLIC_SYSTEM_UART_0_IO_INTERRUPT 1
#define SYSTEM_PLIC_SYSTEM_SPI_0_IO_INTERRUPT 4
#define SYSTEM_PLIC_SYSTEM_USER_TIMER_0_INTERRUPTS_0 19
#define SYSTEM_PLIC_SYSTEM_GPIO_0_IO_INTERRUPTS_0 12
#define SYSTEM_PLIC_SYSTEM_GPIO_0_IO_INTERRUPTS_1 13
#define SYSTEM_RISCV_ISA_RV32I 1
#define SYSTEM_RISCV_ISA_EXT_M 1
#define SYSTEM_RISCV_ISA_EXT_A 0
#define SYSTEM_RISCV_ISA_EXT_C 0
#define SYSTEM_RISCV_ISA_EXT_F 0
#define SYSTEM_RISCV_ISA_EXT_D 0
#define SYSTEM_RISCV_ISA_EXT_ZICSR 1
#define SYSTEM_RISCV_ISA_EXT_ZIFENCE 1
#define SYSTEM_CLINT_HZ 100000000
#define SYSTEM_RAM_A_SIZE 65536
#define SYSTEM_UART_0_IO_PARAMETER_UART_CTRL_CONFIG_DATA_WIDTH_MAX 8
#define SYSTEM_UART_0_IO_PARAMETER_UART_CTRL_CONFIG_CLOCK_DIVIDER_WIDTH 20
#define SYSTEM_UART_0_IO_PARAMETER_UART_CTRL_CONFIG_PRE_SAMPLING_SIZE 1
#define SYSTEM_UART_0_IO_PARAMETER_UART_CTRL_CONFIG_SAMPLING_SIZE 5
#define SYSTEM_UART_0_IO_PARAMETER_UART_CTRL_CONFIG_POST_SAMPLING_SIZE 2
#define SYSTEM_UART_0_IO_PARAMETER_UART_CTRL_CONFIG_CTS_GEN 0
#define SYSTEM_UART_0_IO_PARAMETER_UART_CTRL_CONFIG_RTS_GEN 0
#define SYSTEM_UART_0_IO_PARAMETER_UART_CTRL_CONFIG_RX_SAMPLE_PER_BIT 8
#define SYSTEM_UART_0_IO_PARAMETER_INIT_CONFIG_BAUDRATE 115200
#define SYSTEM_UART_0_IO_PARAMETER_INIT_CONFIG_DATA_LENGTH 7
#define SYSTEM_UART_0_IO_PARAMETER_INIT_CONFIG_PARITY NONE
#define SYSTEM_UART_0_IO_PARAMETER_INIT_CONFIG_STOP ONE
#define SYSTEM_UART_0_IO_PARAMETER_BUS_CAN_WRITE_CLOCK_DIVIDER_CONFIG 1
#define SYSTEM_UART_0_IO_PARAMETER_BUS_CAN_WRITE_FRAME_CONFIG 1
#define SYSTEM_UART_0_IO_PARAMETER_TX_FIFO_DEPTH 64
#define SYSTEM_UART_0_IO_PARAMETER_RX_FIFO_DEPTH 64
#define SYSTEM_CORES_0_CFU 0
#define SYSTEM_CORES_0_FPU 0
#define SYSTEM_CORES_0_MMU 0
#define SYSTEM_CORES_0_ICACHE_WAYS 1
#define SYSTEM_CORES_0_ICACHE_SIZE 4096
#define SYSTEM_CORES_0_BYTES_PER_LINE 64
#define SYSTEM_CORES_0_DCACHE_WAYS 1
#define SYSTEM_CORES_0_DCACHE_SIZE 4096
#define SYSTEM_CORES_0_BYTES_PER_LINE 64
#define SYSTEM_CORES_0_SUPERVISOR 0
#define SYSTEM_BRIDGE_BMB 0x0
#define SYSTEM_RAM_A_CTRL 0xf9000000
#define SYSTEM_RAM_A_CTRL_SIZE 0x10000
#define SYSTEM_BMB_PERIPHERAL_BMB 0xf8000000
#define SYSTEM_BMB_PERIPHERAL_BMB_SIZE 0x1000000
#define SYSTEM_PLIC_CTRL 0xf8c00000
#define SYSTEM_PLIC_CTRL_SIZE 0x400000
#define SYSTEM_CLINT_CTRL 0xf8b00000
#define SYSTEM_CLINT_CTRL_SIZE 0x10000
#define SYSTEM_UART_0_IO_CTRL 0xf8010000
#define SYSTEM_UART_0_IO_CTRL_SIZE 0x40
#define SYSTEM_SPI_0_IO_CTRL 0xf8014000
#define SYSTEM_SPI_0_IO_CTRL_SIZE 0x1000
#define SYSTEM_USER_TIMER_0_CTRL 0xf8016000
#define SYSTEM_USER_TIMER_0_CTRL_SIZE 0x1000
#define SYSTEM_GPIO_0_IO_CTRL 0xf8015000
#define SYSTEM_GPIO_0_IO_CTRL_SIZE 0x100
#endif
