htminuslab/Efinix_T20_Dev_Board/(commit log)

2025-07-15 Initial Release
    [T20Q100_DevBoard_H2.csv, pcbway_parts_list.xls]
2025-07-26 Added Flash support
    Added flash support and renamed some examples
    [external.cfg, flash.cfg, flash_softTap.cfg, flash_ti.cfg, flash_tz.cfg, ftdi.cfg, ftdi_ti.cfg, ftdi_tz.cfg]
2025-08-03 Added PSRAM support
    Added some PSRAM support
    [external.cfg, flash.cfg, flash_softTap.cfg, flash_ti.cfg, flash_tz.cfg, ftdi.cfg, ftdi_ti.cfg, ftdi_tz.cfg]
